OpenLiberty/space-sentry-challenge/instructions/SpaceShip Circuit Schematic.pdf

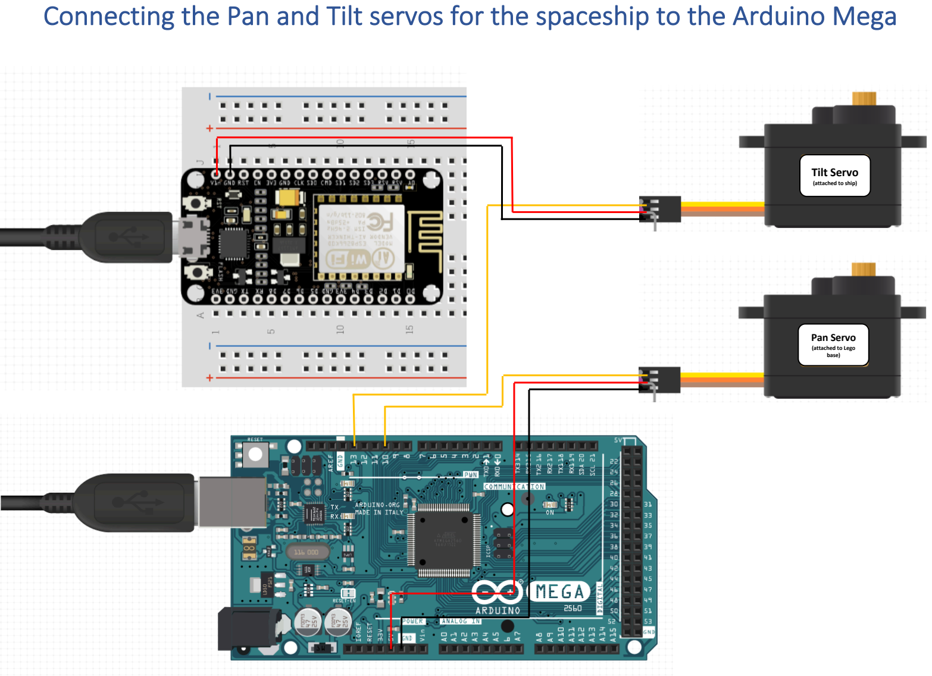
[picture p7: page 1]

Connecting the Pan and Tilt servos for the spaceship to the Arduino Mega

Tilt Servo

(attached to ship)

Pan Servo

(attached to Lego
base)

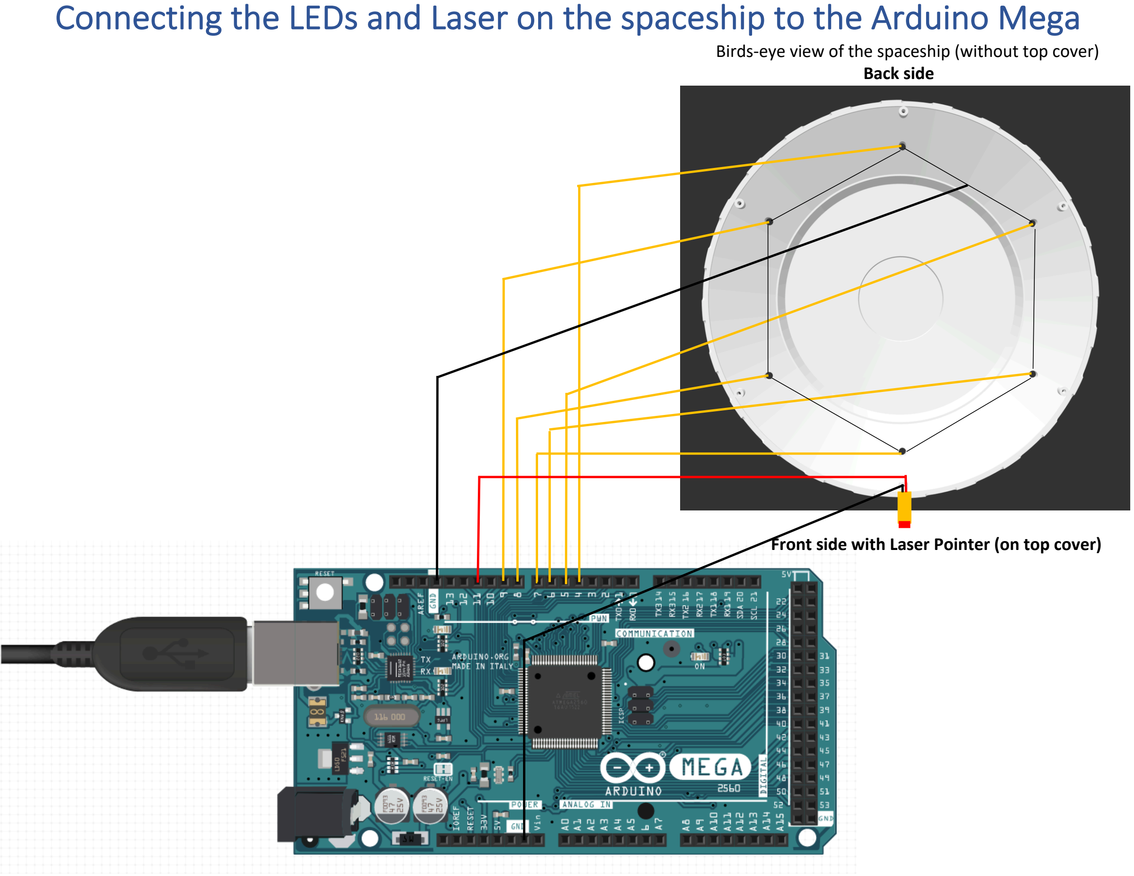
[picture p8: page 2]

Connecting the LEDs and Laser on the spaceship to the Arduino Mega Birds-eye view of the spaceship (without top cover)

Back side

Front side with Laser Pointer (on top cover)

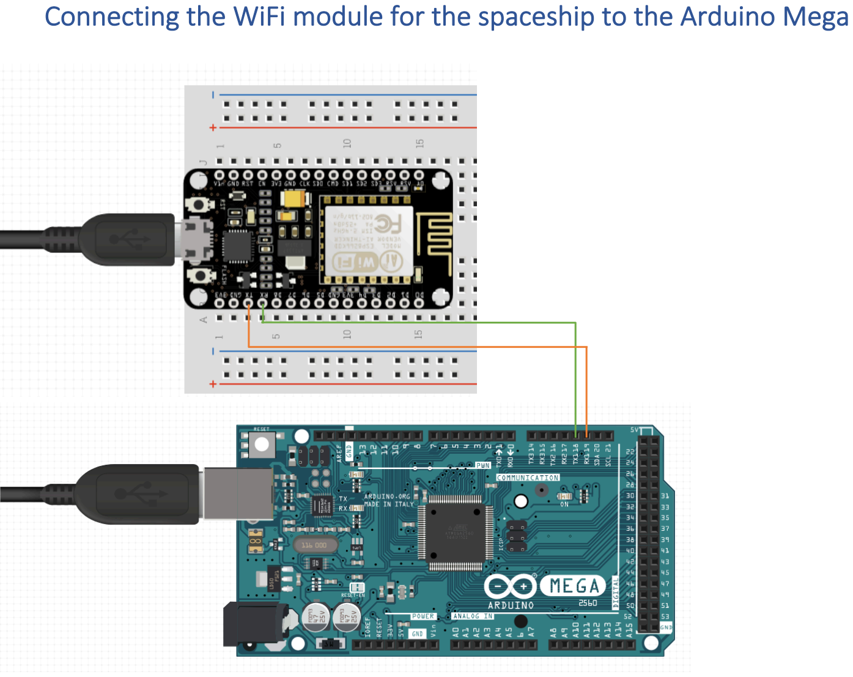
[picture p9: page 3]

Connecting the WiFi module for the spaceship to the Arduino Mega

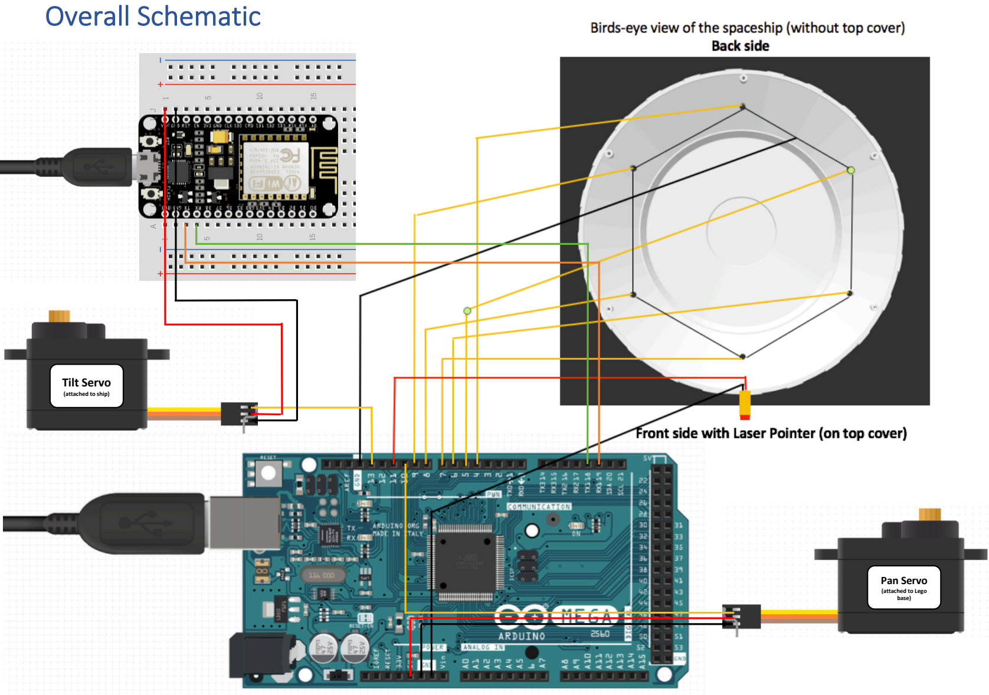
[picture p10: page 4]

Overall Schematic

Tilt Servo

(attached to ship)

Pan Servo

(attached to Lego
base)
