OpenLiberty/space-sentry-challenge/RaspberryPi/python/firstframe.bmp

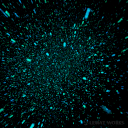
RaspberryPi/python/firstframe.bmp
