OpenLiberty/space-sentry-challenge/RaspberryPi/python/open.jpeg

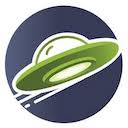
RaspberryPi/python/open.jpeg
