OpenLiberty/space-sentry-challenge/RaspberryPi/python/pulplecloud.gif

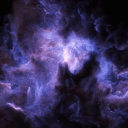
RaspberryPi/python/pulplecloud.gif
