OpenLiberty/space-sentry-challenge/RaspberryPi/python/shootingStar.gif

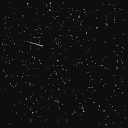
RaspberryPi/python/shootingStar.gif
