OpenLiberty/space-sentry-challenge/RaspberryPi/python/whitehole.gif

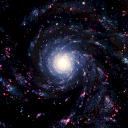
RaspberryPi/python/whitehole.gif
