OpenLiberty/space-sentry-challenge/hardware/parts-list.md

Required Tools
---
- Soldering Iron (Generic)
- Solder Wire (Lead Free)
- Wire Strippers (Capable of stripping 22-28 AWG wiring)
- Open Barrel Terminal Crimper (Capable of crimping 22-28 AWG wiring)
- Wire Cutters (Generic)
- Spools of 24AWG Flex Wire (multiple colours)
- Hook-up Wire 24AWG (multiple colours)
- Heat Shrink Tubing (multiple sizes)
- Desolder Pump
- Thin Tipped Tweezers (makes the soldering of the surface mount resistors much easier)
- Helping Hands (makes the soldering of wires much easier)
- Fine Conical Soldering Iron Tip (makes the soldering of small components easier)
- Multimeter (not necessary for the functionality of the build, however is very useful in the building and testing phases)

Required Components:
---
- The custom PCB Arduino shield documentation can be found in the [pcb-shield.md](pcb-shield.md) file, for steps on ordering the boards, refer to the [pcb-ordering.md](pcb-ordering.md) file.
- Arduino MEGA 2560
- USB-A Female Surface Mount Socket
- 5V 1A USB Port Power Supply
- USB-A Cable
- ESP8266 Wifi Module
- Female to Female Jumper Wire
- Break-away 0.1" Dual Row Male Header Pin Strip (at least 18 long)
- Break-away 0.1" Single Row Male Header Pin Strip (at least 10 long)
- Break-away 0.1" Single Row Dual Side Male Header Pin Strip (at least 4 long)
- 51 x Molex Part #39000046 (Mini-Fit Female Crimp Terminal 22-28 AWG)
- 51 x Molex Part #39000048 (Mini-Fit Male Crimp Terminal 22-28 AWG)
- 5 x Micro Servo
- 5 x 12mm Photoresistor
- 5 x 10kOhm 1206 SMD Resistors

Servo Connectors:
- 1 x Molex Part #39012160 (Intermediate connector for servo wires (M) 16 wire)
- 1 x Molex Part #39289168 (Board connector for servo wires (F) 16 wire)
- 5 x Molex Part #39014032 (Intermediate connector for servo wires (M) 3 wire)
- 5 x Molex Part #39014030 (Intermediate connector for servo wires (F) 3 wire)

Photoresistor Connectors:
- 1 x Molex Part #39012100 (Intermediate connector for the photo-resistors (M) 10 wire)
- 1 x Molex Part #39289108 (Board connector for the photo-resistors (F) 10 wire)
- 5 x Molex Part #39012020 (Intermediate connector for the photo-resistors (M) 2 wire)
- 5 x Molex Part #39012021 (Intermediate connector for the photo-resistors (F) 2 wire)

Suggested Retailors and Notes:
---
Note that the quantities listed for the components above are the _required minimum_. It is highly recommended to buy multiple extras as there will be parts that will get lost or broken.

Most of the components were purchased through the **[Digi-Key](https://www.digikey.ca/)** website. Copy the part number as listed above, and throw them in the product search window of the website.



An example using the part #39012160:



The common parts and tools can also be easily found in your local electronic hobby stores. Amazon is also a reliable and quick online retailor.
