OpenLiberty/space-sentry-challenge/instructions/assets/images/esp-connect.jpg

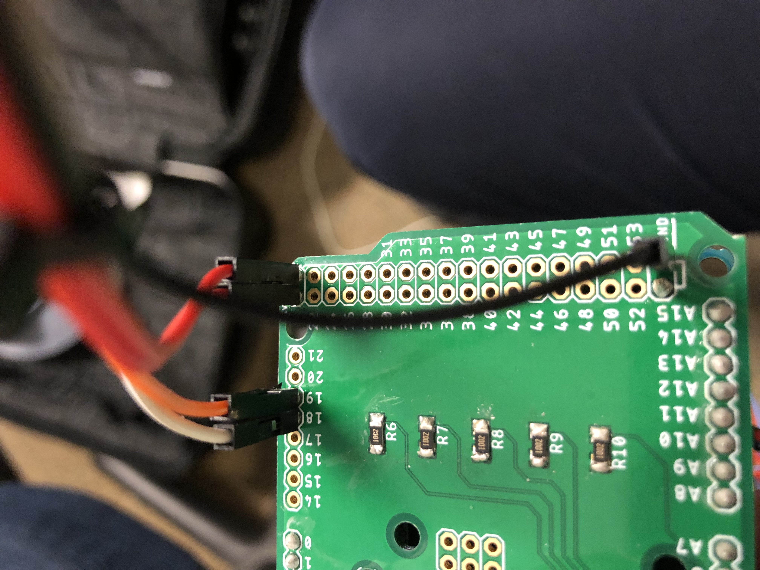
instructions/assets/images/esp-connect.jpg
