OpenLiberty/space-sentry-challenge/instructions/assets/images/IMG_1947.jpg

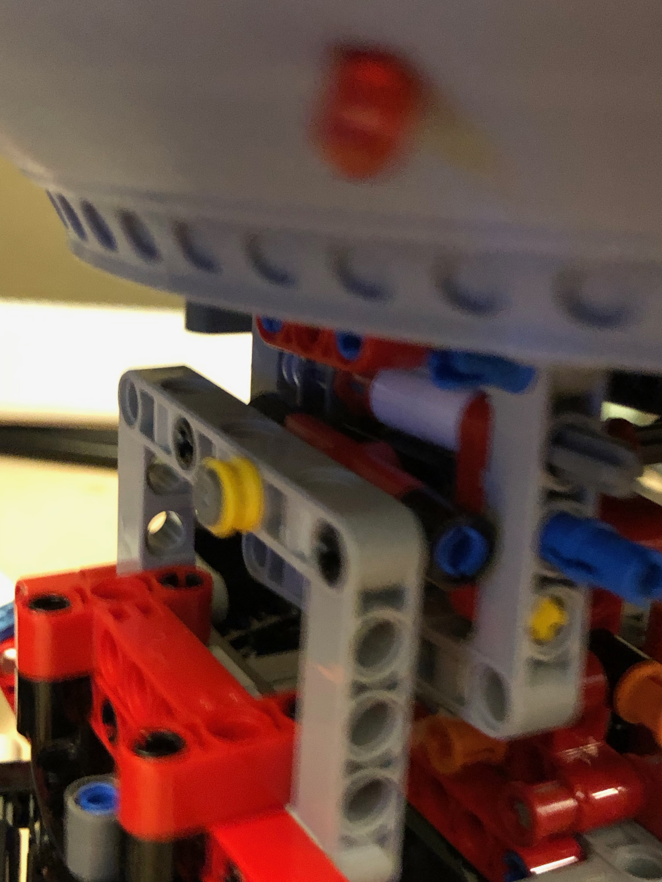
instructions/assets/images/IMG_1947.jpg
