OpenLiberty/space-sentry-challenge/instructions/assets/images/IMG_1948.jpg

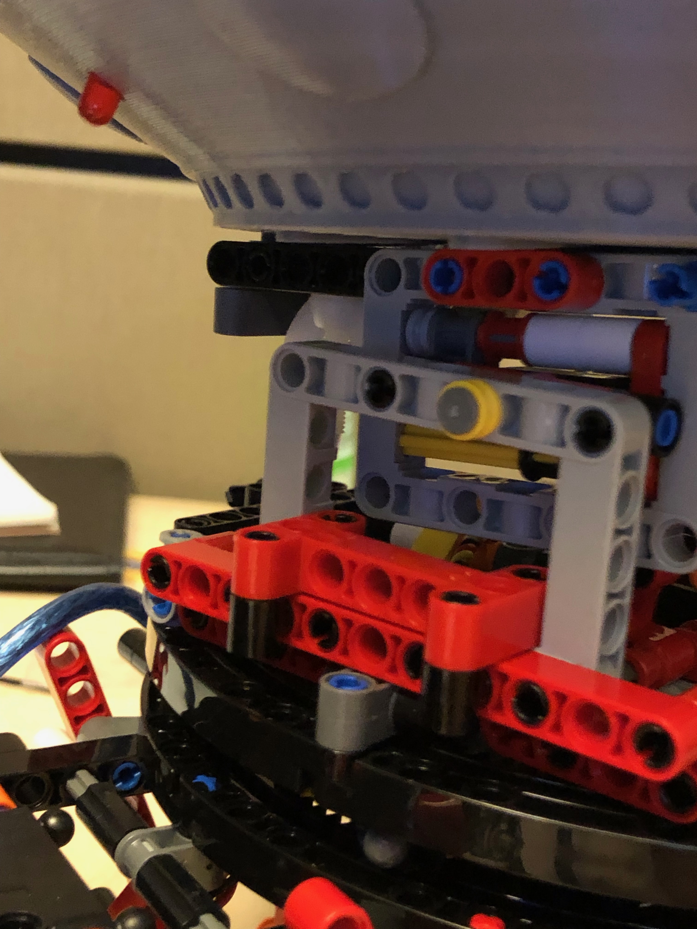
instructions/assets/images/IMG_1948.jpg
