OpenLiberty/space-sentry-challenge/instructions/assets/images/IMG_1951.jpg

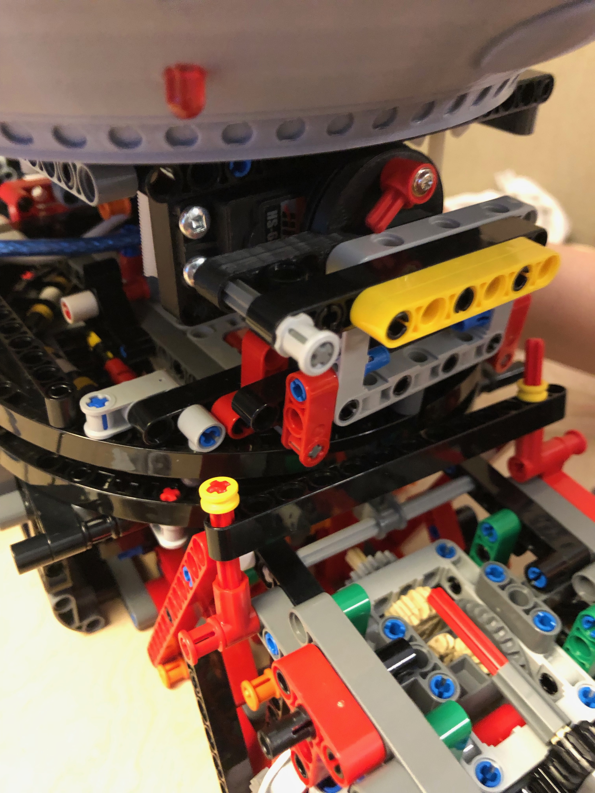
instructions/assets/images/IMG_1951.jpg
