OpenLiberty/space-sentry-challenge/instructions/assets/images/IMG_1952.jpg

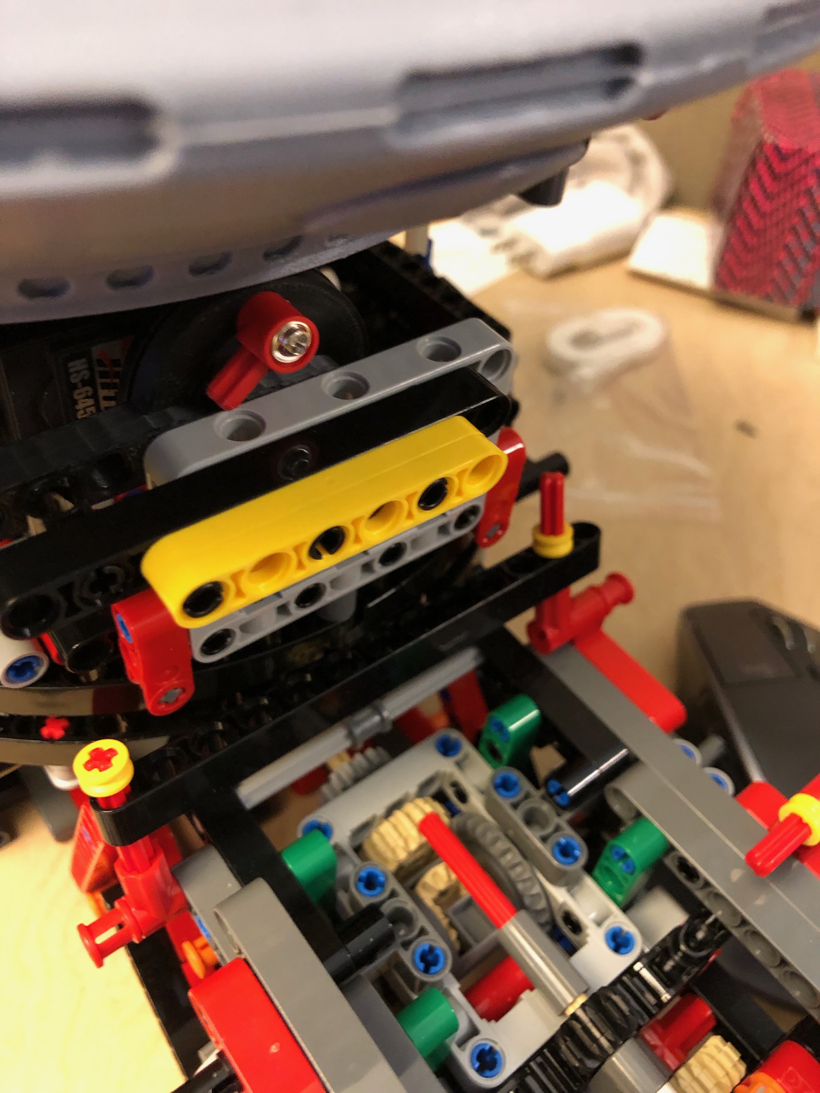
instructions/assets/images/IMG_1952.jpg
