OpenLiberty/space-sentry-challenge/instructions/assets/images/IMG_1953.jpg

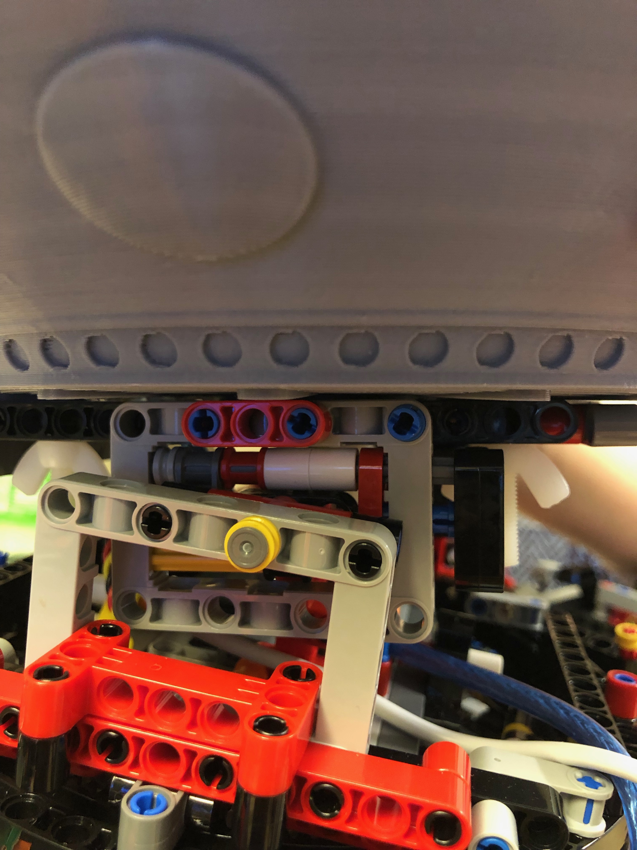
instructions/assets/images/IMG_1953.jpg
