OpenLiberty/space-sentry-challenge/instructions/assets/images/IMG_1954.jpg

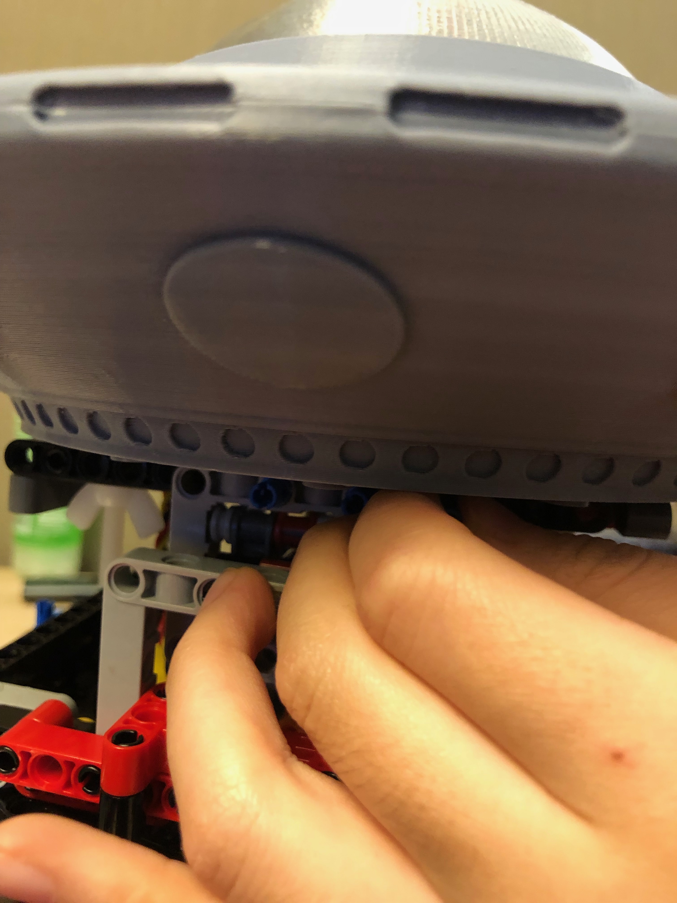
instructions/assets/images/IMG_1954.jpg
