OpenLiberty/space-sentry-challenge/instructions/assets/images/IMG_1957.jpg

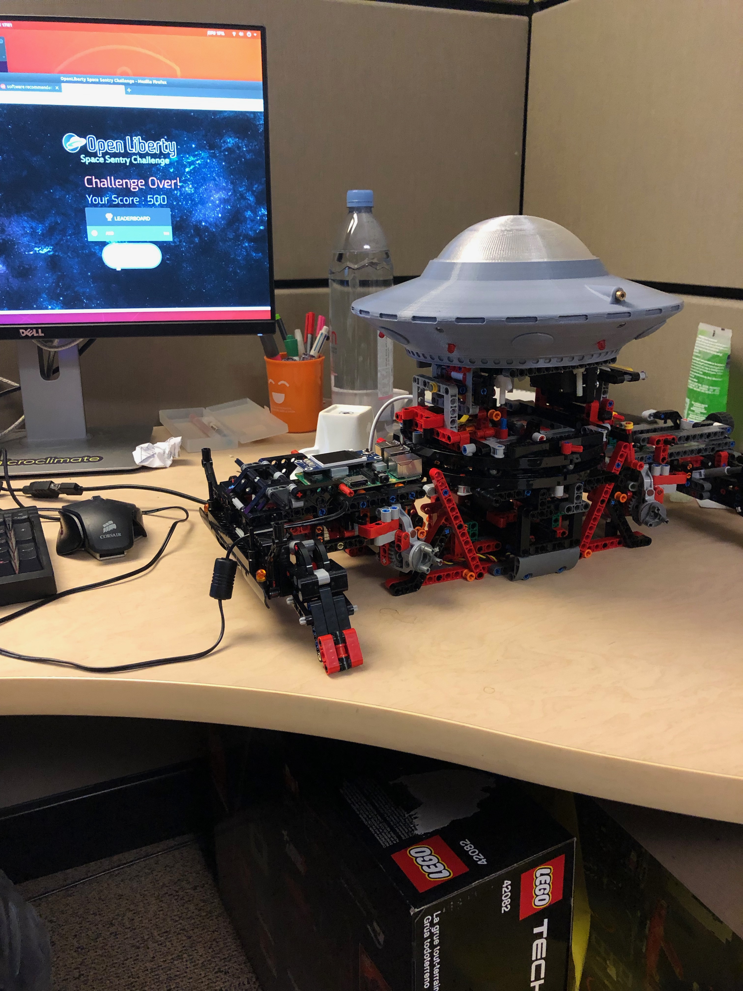
instructions/assets/images/IMG_1957.jpg
