OpenLiberty/space-sentry-challenge/instructions/assets/images/IMG_1965.jpg

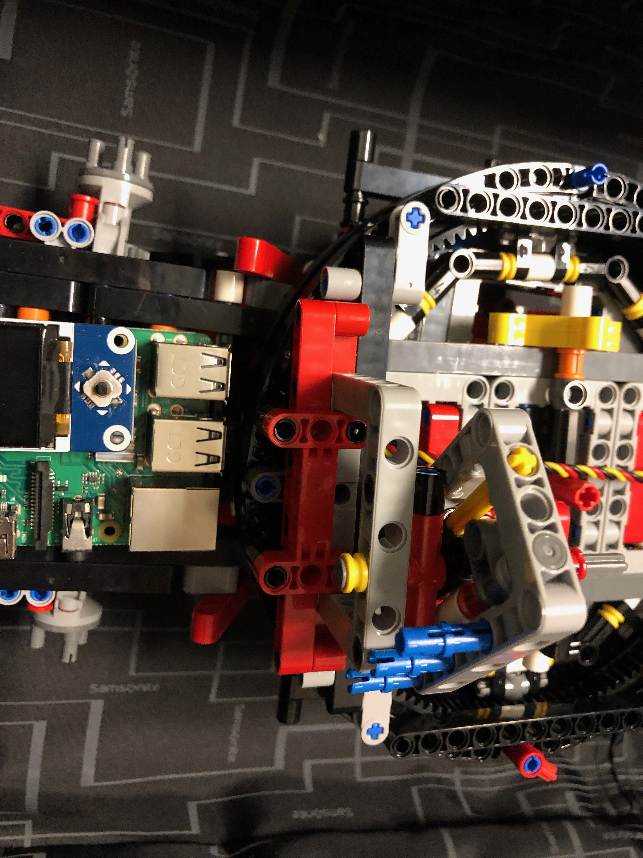
instructions/assets/images/IMG_1965.jpg
