OpenLiberty/space-sentry-challenge/instructions/assets/images/IMG_1966.jpg

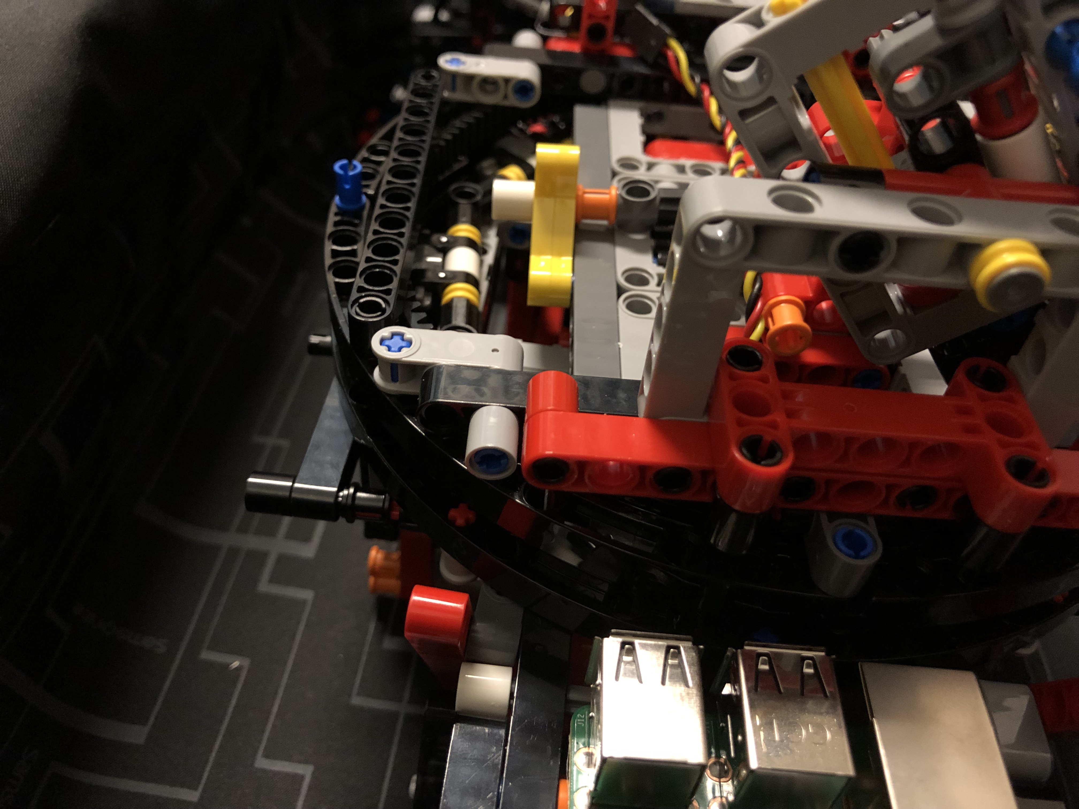
instructions/assets/images/IMG_1966.jpg
