OpenLiberty/space-sentry-challenge/instructions/assets/images/IMG_1967.jpg

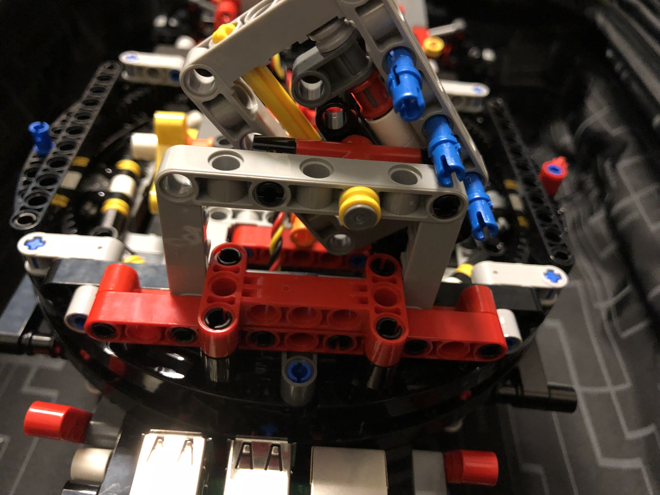
instructions/assets/images/IMG_1967.jpg
