OpenLiberty/space-sentry-challenge/instructions/assets/images/IMG_1968.jpg

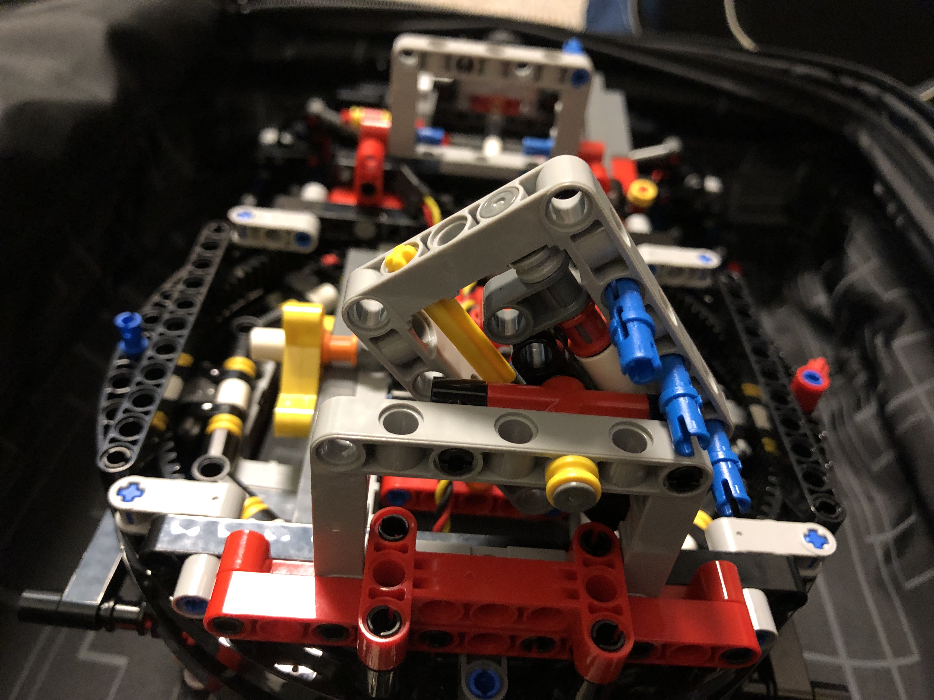
instructions/assets/images/IMG_1968.jpg
