OpenLiberty/space-sentry-challenge/instructions/assets/images/IMG_1969.jpg

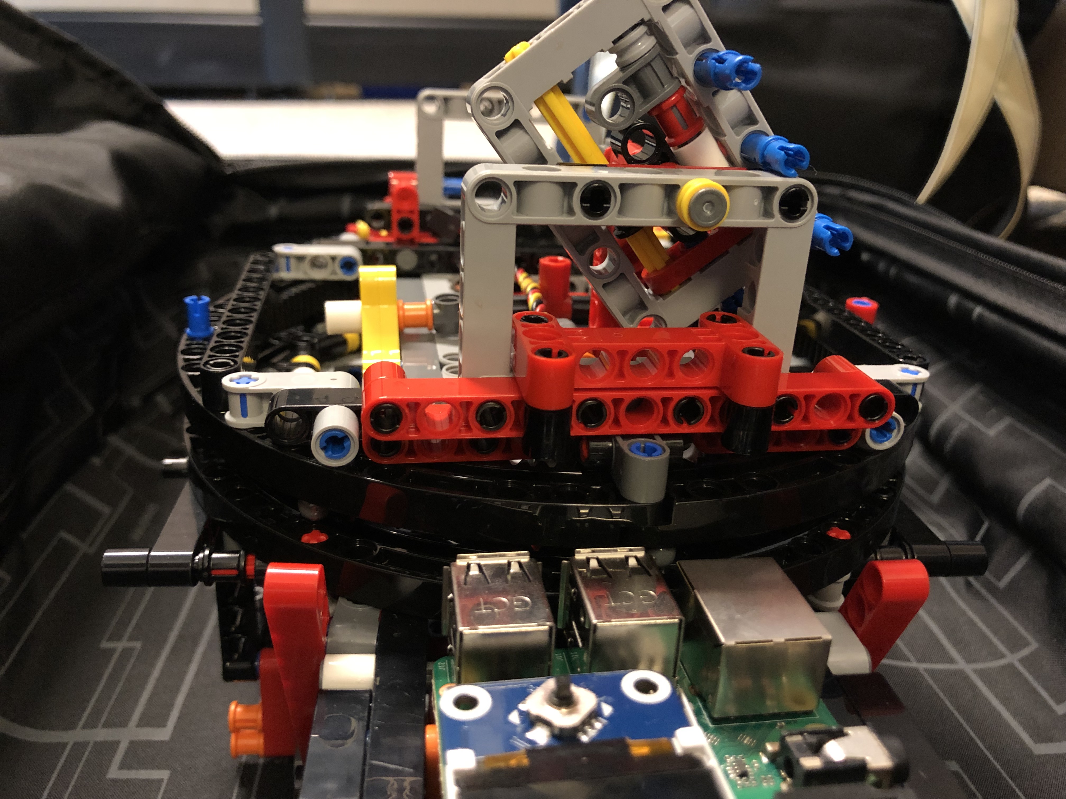
instructions/assets/images/IMG_1969.jpg
