OpenLiberty/space-sentry-challenge/instructions/assets/images/IMG_1970.jpg

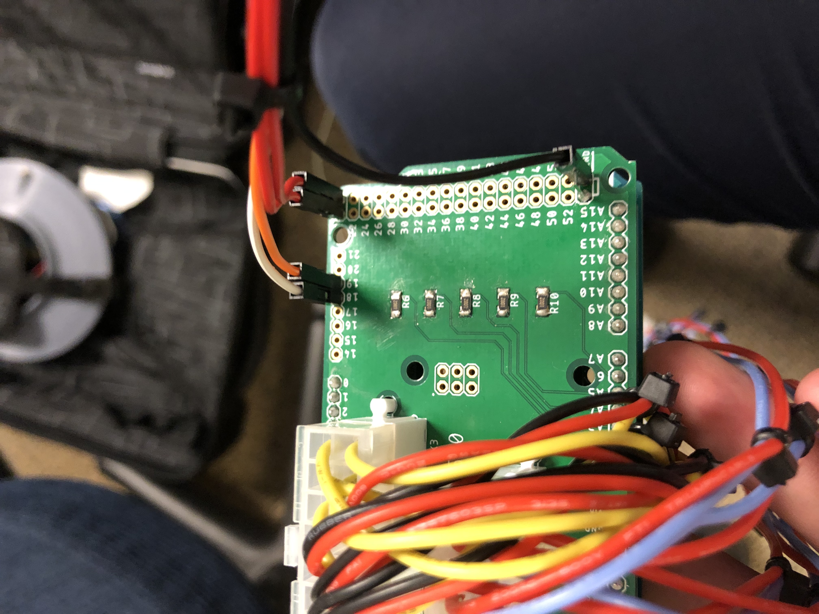
instructions/assets/images/IMG_1970.jpg
