OpenLiberty/space-sentry-challenge/instructions/assets/images/IMG_1972.jpg

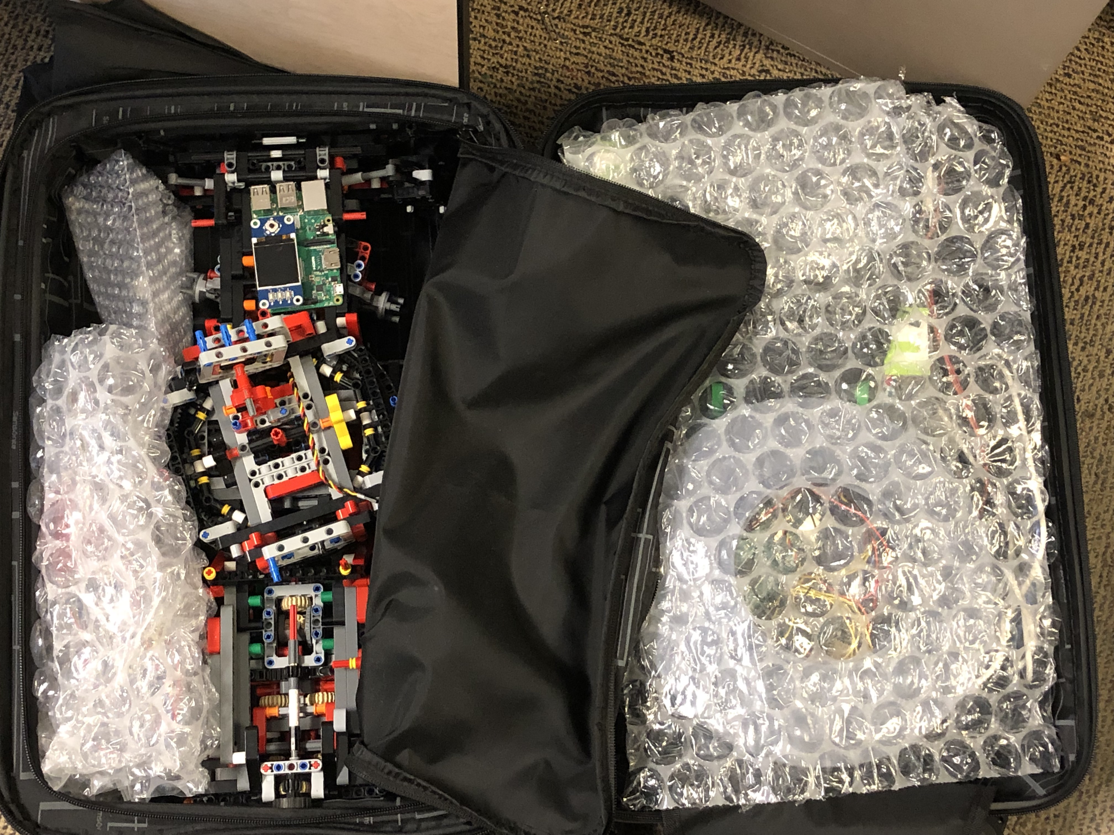
instructions/assets/images/IMG_1972.jpg
