OpenLiberty/space-sentry-challenge/instructions/assets/images/IMG_1973.jpg

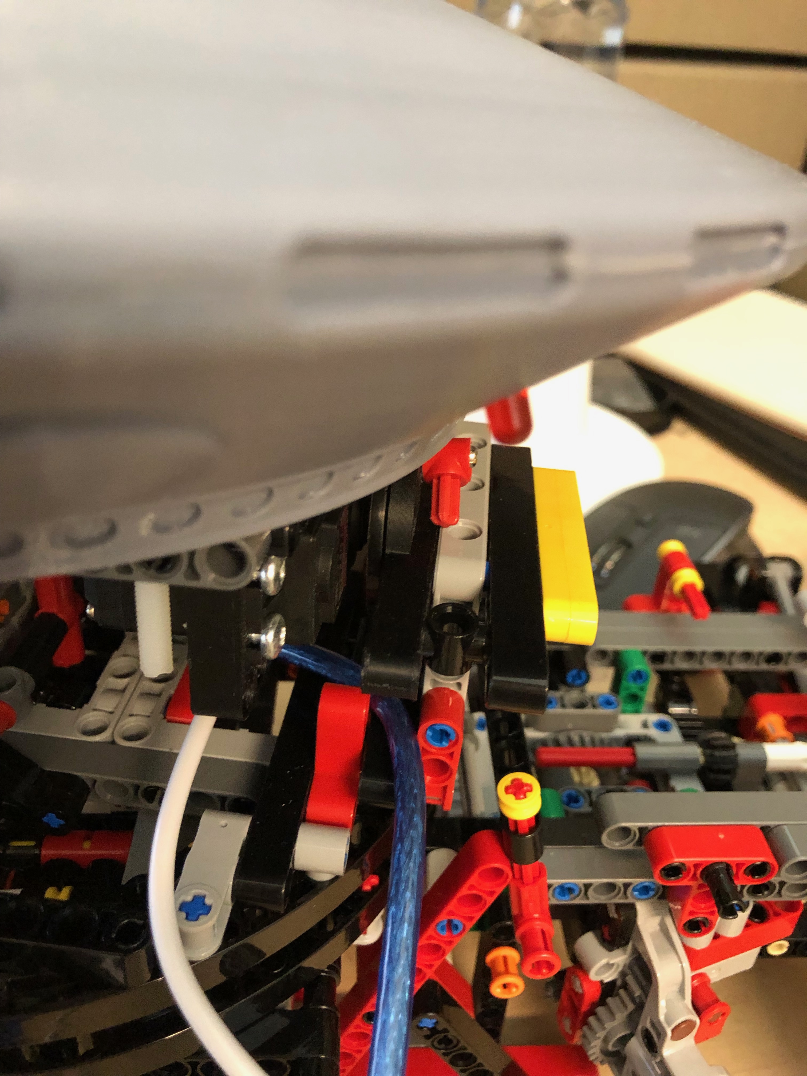
instructions/assets/images/IMG_1973.jpg
