OpenLiberty/space-sentry-challenge/instructions/assets/images/IMG_1974.jpg

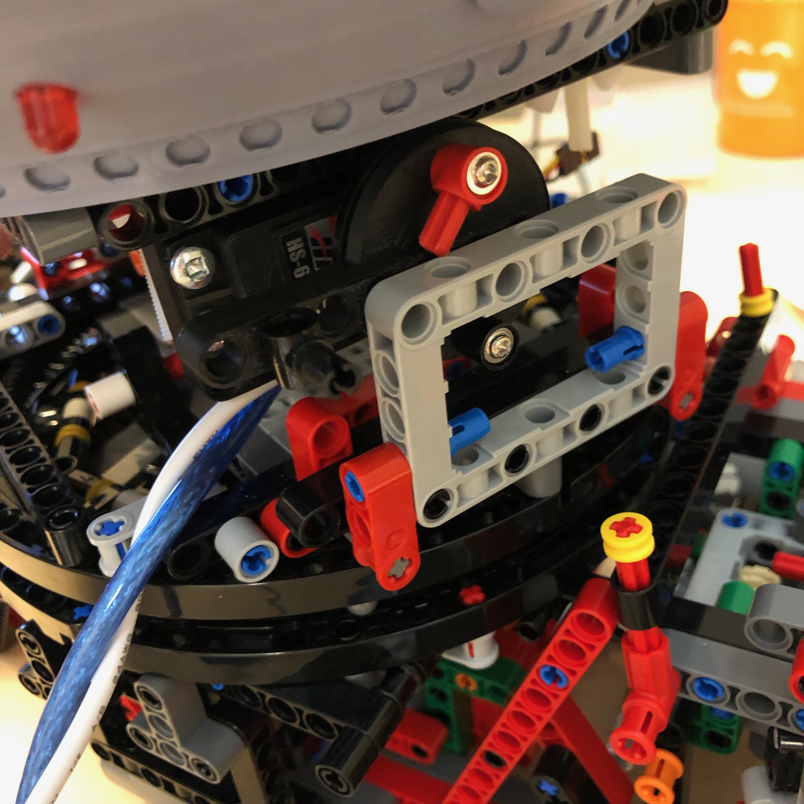
instructions/assets/images/IMG_1974.jpg
