OpenLiberty/space-sentry-challenge/instructions/assets/images/leftside-1.jpg

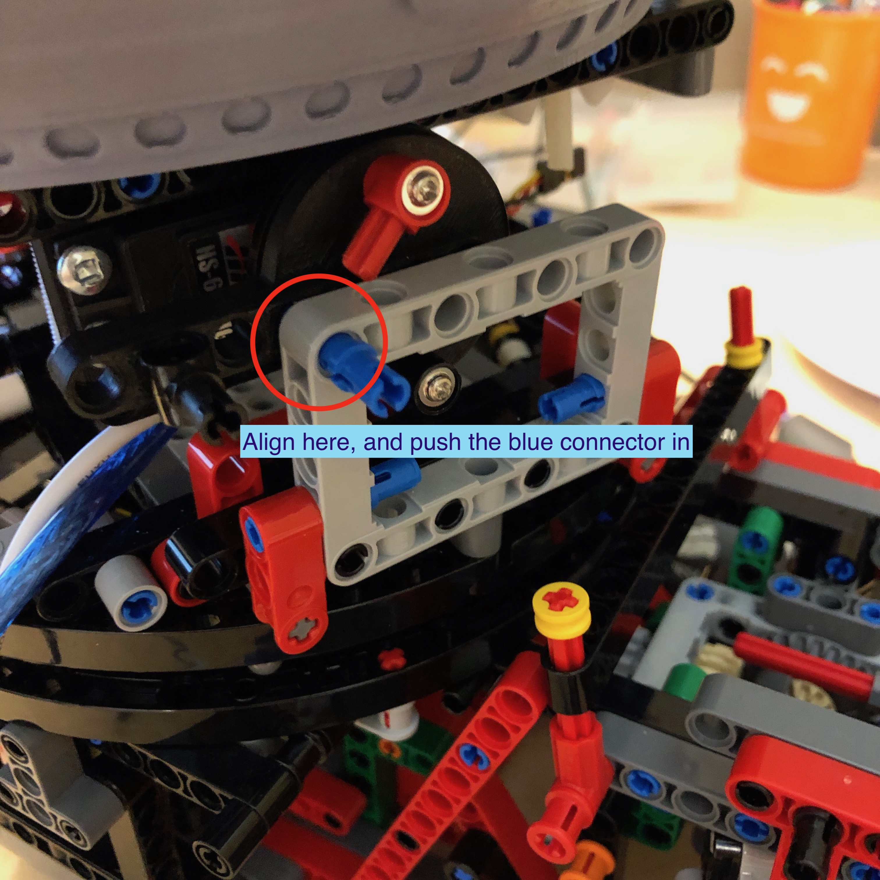
instructions/assets/images/leftside-1.jpg
