OpenLiberty/space-sentry-challenge/instructions/assets/images/leftside-2.jpg

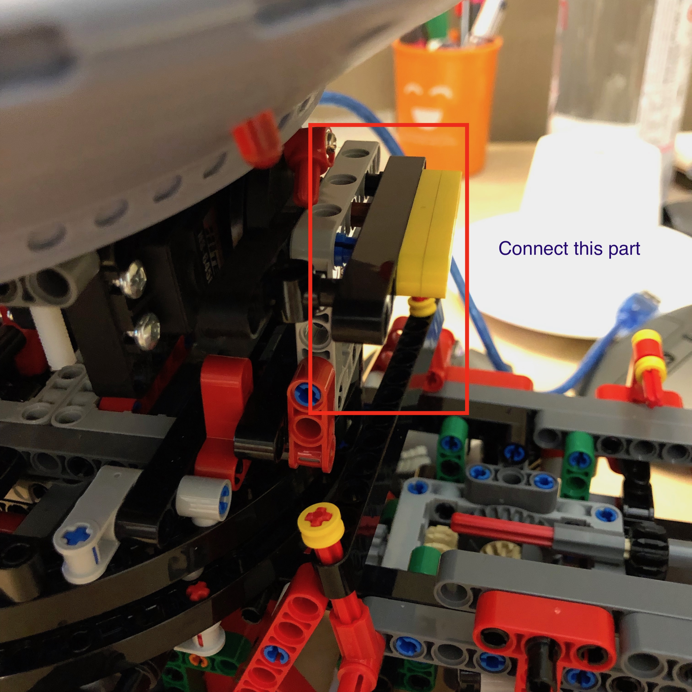
instructions/assets/images/leftside-2.jpg
