OpenLiberty/space-sentry-challenge/instructions/assets/images/leftside-3.jpg

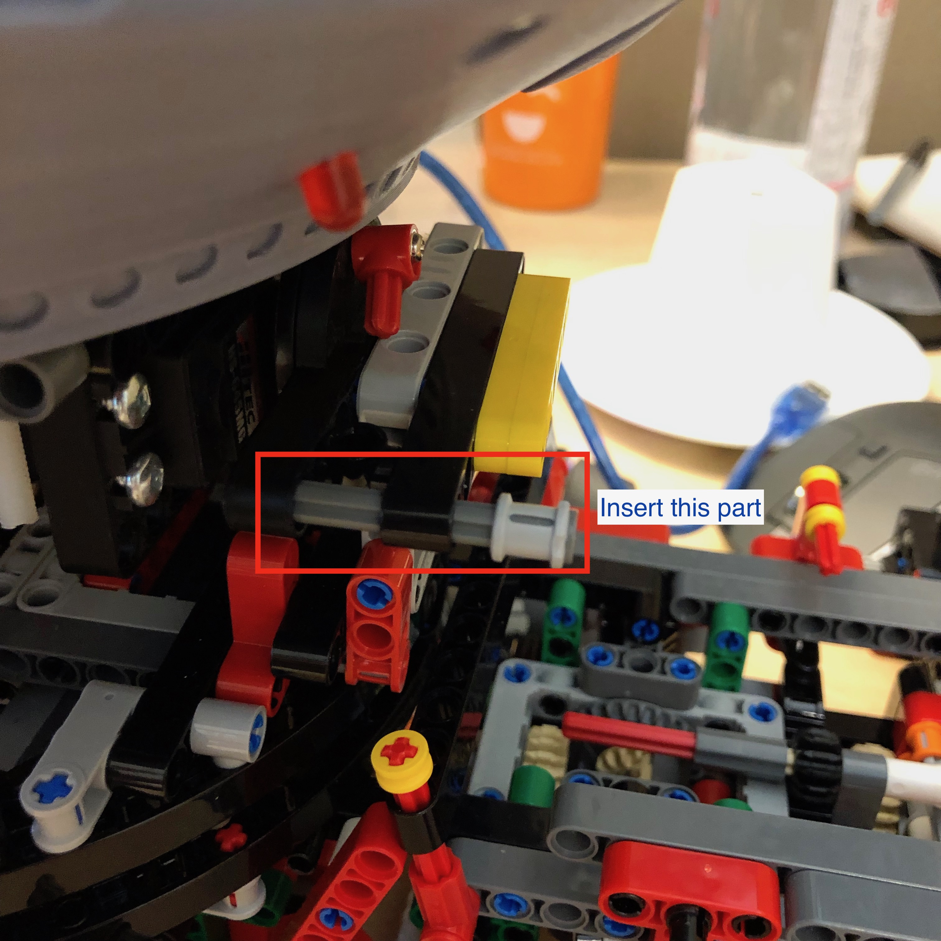
instructions/assets/images/leftside-3.jpg
