OpenLiberty/space-sentry-challenge/instructions/assets/images/mini-display.jpg

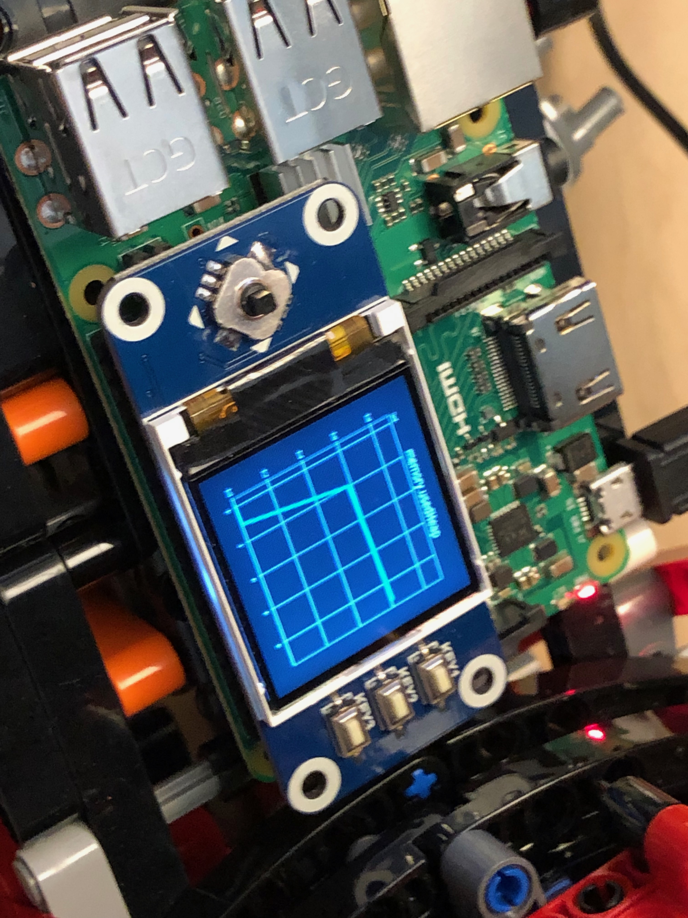
instructions/assets/images/mini-display.jpg
