OpenLiberty/space-sentry-challenge/instructions/assets/images/minipc-power.jpg

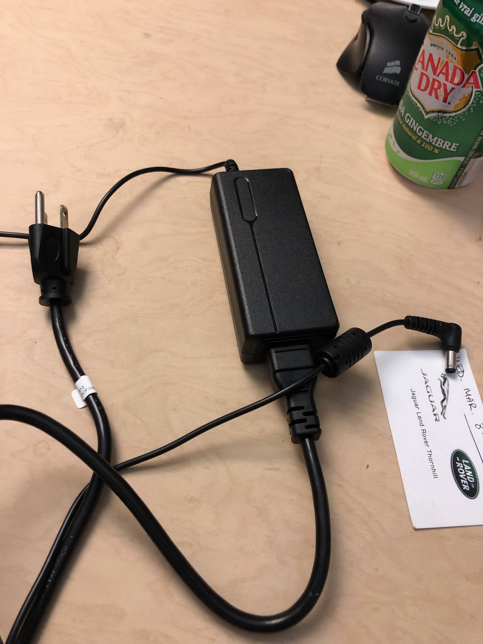
instructions/assets/images/minipc-power.jpg
