OpenLiberty/space-sentry-challenge/instructions/assets/images/minipc.jpg

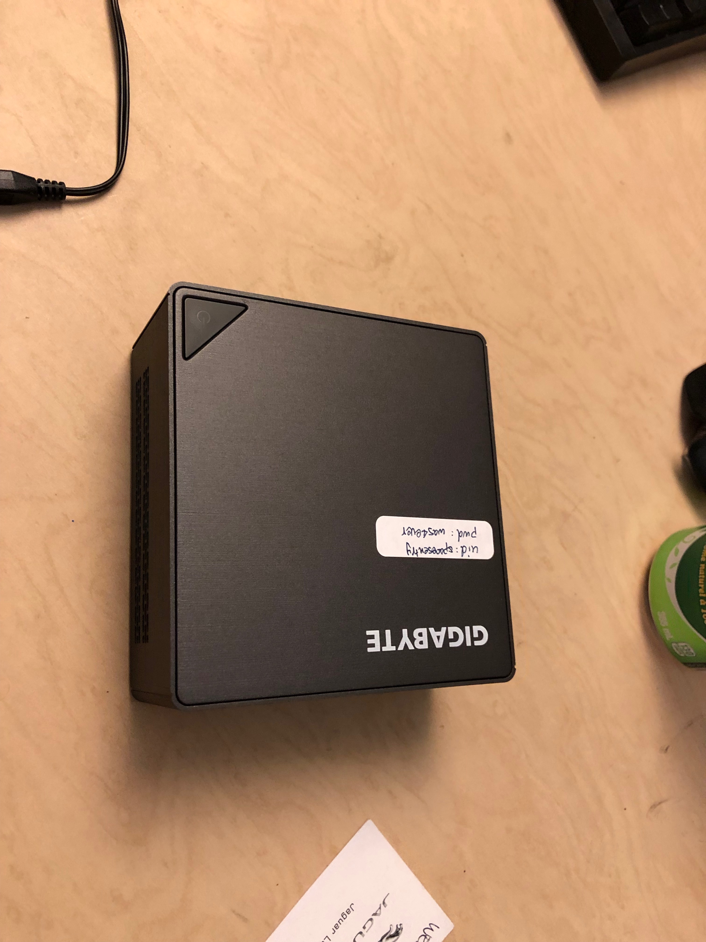
instructions/assets/images/minipc.jpg
