OpenLiberty/space-sentry-challenge/instructions/assets/images/rightside-1.jpg

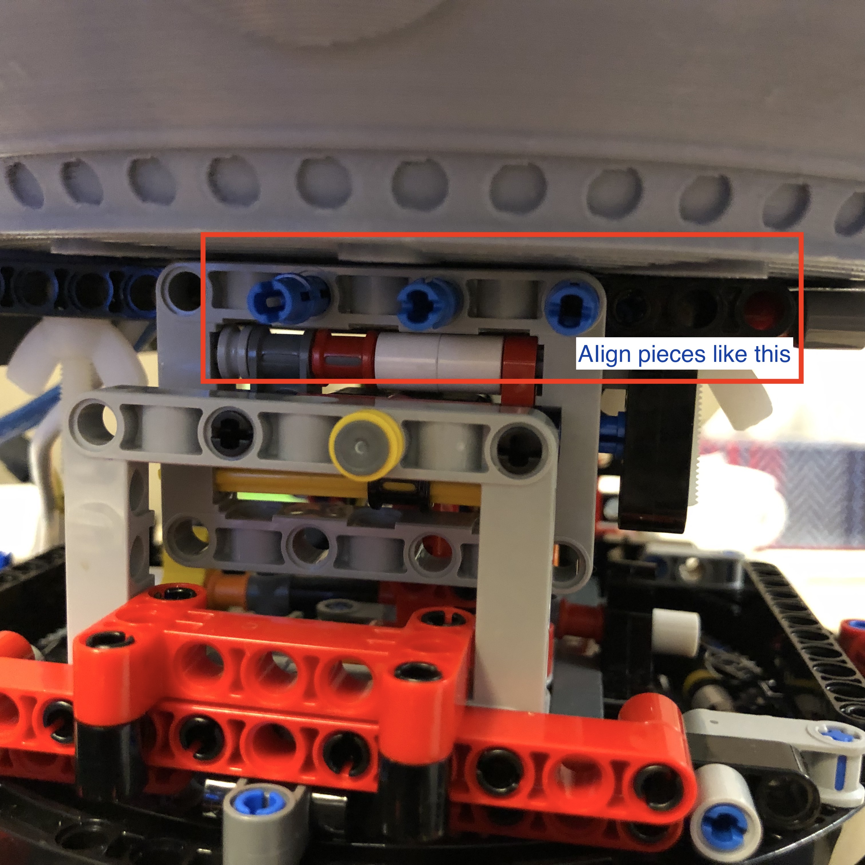
instructions/assets/images/rightside-1.jpg
