OpenLiberty/space-sentry-challenge/instructions/assets/images/rightside-2.jpg

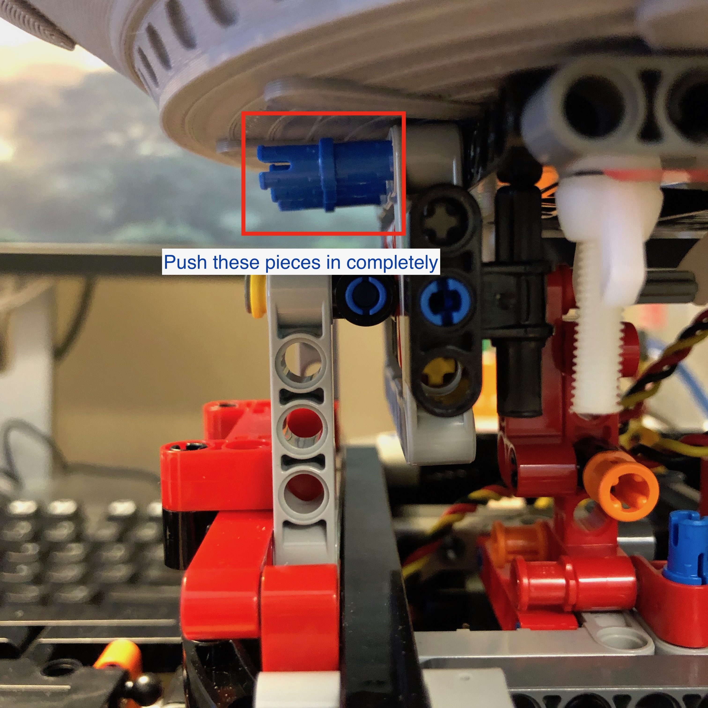
instructions/assets/images/rightside-2.jpg
