OpenLiberty/space-sentry-challenge/instructions/assets/images/rightside-3.jpg

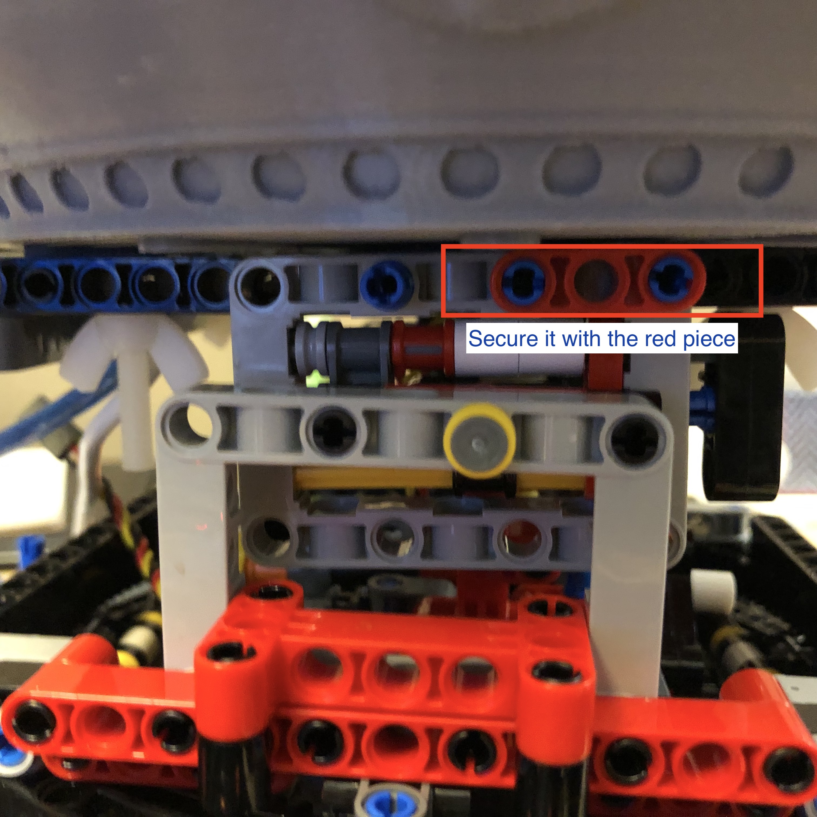
instructions/assets/images/rightside-3.jpg
