OpenLiberty/space-sentry-challenge/instructions/assets/images/servo-connect2.jpg

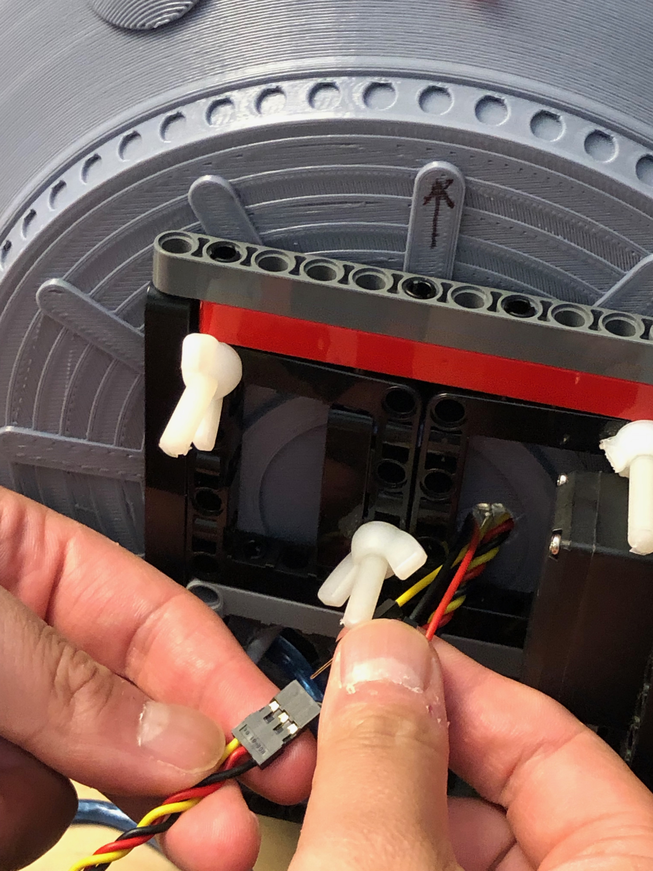
instructions/assets/images/servo-connect2.jpg
