OpenLiberty/space-sentry-challenge/instructions/assets/images/servo-connect.jpg

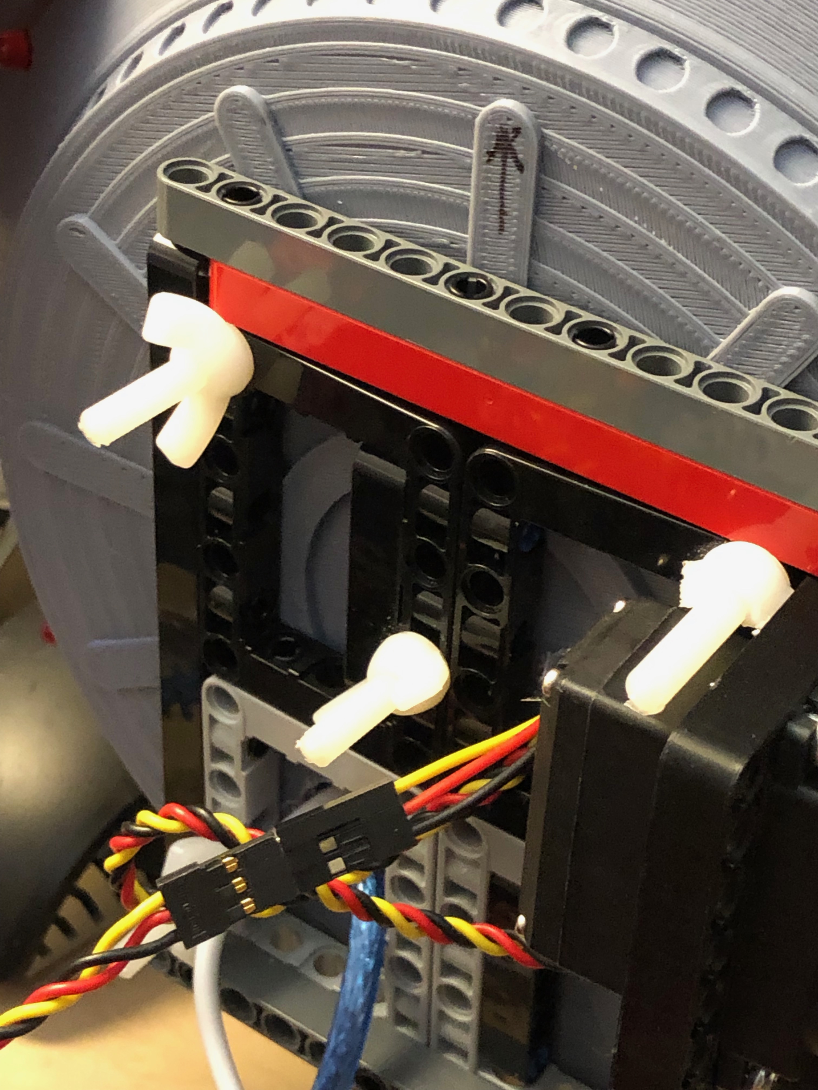
instructions/assets/images/servo-connect.jpg
