OpenLiberty/space-sentry-challenge/instructions/assets/images/targets-arduino.jpg

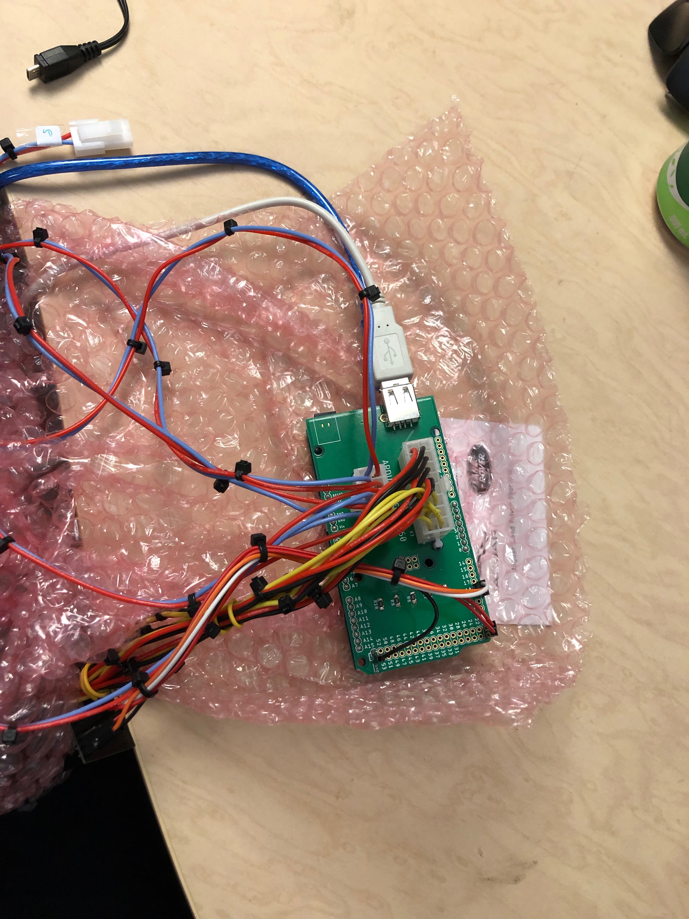
instructions/assets/images/targets-arduino.jpg
