OpenLiberty/space-sentry-challenge/instructions/assets/images/targets-connect.jpg

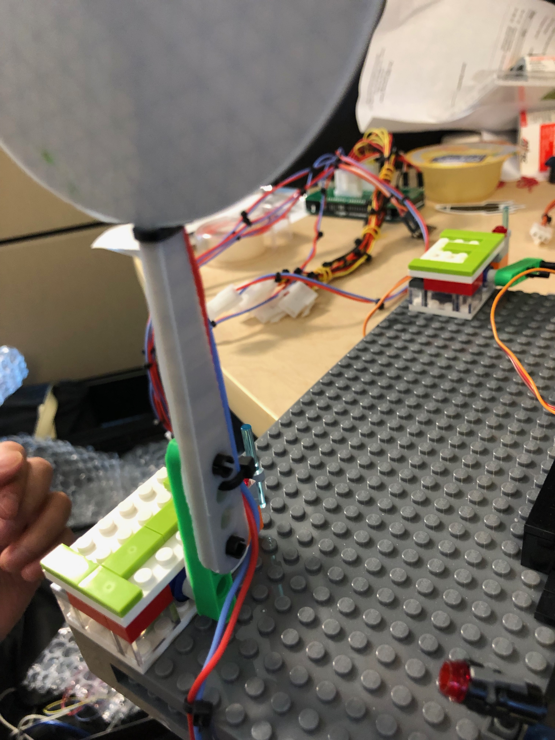
instructions/assets/images/targets-connect.jpg
