OpenLiberty/space-sentry-challenge/(threads)

Thread 2 (2019-05-30):

Usable browser back button that won't break the game

fwji, 2019-05-30:
Currently, hitting the back button in admin page or in the middle of the game session (as well as the leaderboard page) will not properly clean up all the resources. As a result, it will lead the whole web app to an unpredictable state.

Closed 2019-08-14.

Thread 7 (2019-05-30):

Adding a monitor to raspberry pi to display liberty logo and other animation

fwji, 2019-05-30:

BriannaLi, 2019-06-04:
Setting up git and python environment on Raspberry Pi. Installing image library. Doubt the ability of playing animation on 1.44 LCD

BriannaLi, 2019-06-04:
It is showing images. Adjusting open liberty logo for display.

BriannaLi, 2019-06-04:
Displaying Liberty logo

BriannaLi, 2019-06-04:
Trying to introduce tkinter for gif display.

BriannaLi, 2019-06-04:
May need low level code to display gif.

BriannaLi, 2019-06-05:
Able to change font of text

BriannaLi, 2019-06-05:
Adding sound

fwji, 2019-06-05:
<pre>
Container              Status
Admin                    Running
Game                     Running
Leaderboard         Running
nginx                     Running
mongo                  Running
</pre>

BriannaLi, 2019-06-06:
Added shooting effect. Adding blinking stars

BriannaLi, 2019-06-06:
Admin                    ●
Game                     ●
Leaderboard         ●
nginx                      ●
mongo                   ●

BriannaLi, 2019-06-07:
Got buttons work with GEIO library #20

fwji, 2019-06-10:
Sample JSON data to consume:

{"checks":[{"data":{"services":"available"},"name":"InventoryResource","state":"UP"},{"data":{"default server":"available"},"name":"SystemResource","state":"UP"}],"outcome":"UP"}

BriannaLi, 2019-06-13:
https://openliberty.io/guides/microprofile-health.html

BriannaLi, 2019-06-13:
Able to get and display json data from url(openliberty service)

BriannaLi, 2019-06-13:
Adding url not find exception

Closed 2019-06-18.

Thread 13 (2019-06-05):

Shopping List

fwji, 2019-06-05:
1. New router

MaiHameed, 2019-06-08:
*Arduino [Mega](https://store.arduino.cc/usa/mega-2560-r3)*

The Mega has 15 PWM ports, which eliminates the need of the intermediary PWM board that was used to power the servos. We can plug the motors straight into the Mega instead.

MaiHameed, 2019-06-12:
**Multimeter**

For obvious reasons :D

DannyS03, 2019-06-12:
Multi-meter

MaiHameed, 2019-06-13:
[USB-C Hub](https://www.amazon.ca/dodowin-Multiport-Ethernet-Thunderbolt-Compatible/dp/B07LBR5PBB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)

MaiHameed, 2019-07-15:
Intermediate connector for servo wires (M) 16 wire
1 x [39012160](https://www.digikey.ca/products/en?keywords=39012160)

Board connector for servo wires (F) 16 wire
1 x [39289168](https://www.digikey.ca/products/en?keywords=39289168)

Intermediate connector for servo wires (M) 3 wire
5 x [39014032](https://www.digikey.ca/products/en?keywords=39014032)

Intermediate connector for servo wires (F) 3 wire
5 x [39014030](https://www.digikey.ca/products/en?keywords=39014030)

Intermediate connector for the photo-resistors (M) 10 wire
1 x [39012100](https://www.digikey.ca/products/en/connectors-interconnects/rectangular-connectors-housings/319?k=39012100)

Board connector for the photo-resistors (F) 10 wire
1 x [39289108](https://www.digikey.ca/products/en?keywords=39289108)

Intermediate connector for the photo-resistors (M) 2 wire
5 x [39012020](https://www.digikey.ca/products/en?keywords=39012020)

Intermediate connector for the photo-resistors (F) 2 wire
5 x [39012021](https://www.digikey.ca/products/en?keywords=39012021)

Mini-Fit Female Crimp Terminal 22-28 AWG
51 x [39000046](https://www.digikey.ca/product-detail/en/molex/0039000046/WM2503TR-ND/1643436)

Mini-Fit Male Crimp Terminal 22-28 AWG
51 x [39000048](https://www.digikey.ca/product-detail/en/molex/0039000048/WM2502TR-ND/1643437)

6 multi-coloured spools of 22 AWG wire - SparkFun
1 x [PRT-11367](https://www.digikey.ca/product-detail/en/sparkfun-electronics/PRT-11367/1568-1357-ND/5956251)

Titan 11477 Ratcheting Wire Terminal Crimper
1 x [Titan 11477](https://www.amazon.ca/Titan-11477-Ratcheting-Terminal-Crimper/dp/B0069TRKJ0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)

Weller WLC100CUL 40-Watt Soldering Station
1 x [Weller WLC100CUL](https://www.amazon.ca/Weller-WLC100CUL-40-Watt-Soldering-Station/dp/B00PVV6T1C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)

Weller ST7 TIP, CONICAL, 1/32"
1 x [ST7 TIP](https://www.amazon.ca/Weller-ST7-Conical-Solder-Hobbyist/dp/B0002BSP4K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)

Soldering Wire 0.031" (0.79mm)
1 x [0.79mm](https://www.digikey.ca/product-detail/en/chip-quik-inc/RASWLF.031-1OZ/RASWLF.0311OZ-ND/9681997)

Soldering Wire 0.015" (0.38mm)
1 x [0.38mm](https://www.digikey.ca/product-detail/en/chip-quik-inc/RASWLF.015-2OZ/RASWLF.0152OZ-ND/9682012)

MaiHameed, 2019-07-18:
10k Ohm Resistors
5 x [0603 10k](https://www.digikey.ca/product-detail/en/stackpole-electronics-inc/RNCP0603FTD10K0/RNCP0603FTD10K0CT-ND/2240478)

MaiHameed, 2019-08-21:
Shopping list is outdated, some components I ordered ended up not being correct and I switched a few around. For an updated list, check out the [parts-list.md](hardware/parts-list.md) file.

Closed 2019-08-21.

Thread 15 (2019-06-05):

Redesign the Web Application

pgunapal, 2019-06-05:
The current web application is a simple web page, that uses HTML, CSS, JavaScript/jQuery. It would be better to use the latest frameworks that are available for web designing, such as Angular, NodeJS, React, and etc.

Thread 16 (2019-06-05):

Some sound track is not working during game session

fwji, 2019-06-05:

fwji, 2019-07-10:
Seems like newest browser will automatically block sound being played from untrusted sources. Still unclear why some sound can still be played. But this can be fixed by simply configuring the browser to allow audio playback in any circumstances

Closed 2019-07-10.

Thread 9 (2019-06-05):

Keystroke recognition with Arduino

mavelyc, 2019-06-05:
Look into and integrate keystroke/keyboard input to locally test Arduino code with the servo motor

Closed 2019-06-12.

Thread 20 (2019-06-07):

Get buttons to work with monitor

BriannaLi, 2019-06-07:
Based on schematics, each buttons was assigned to a GEIO pin. Gonna bring in gpiozero library in to add button control.

http://www.waveshare.net/w/upload/6/6f/1.44inch-LCD-HAT-Schematic.pdf
http://www.waveshare.net/w/upload/9/9d/1.44inch_LCD_HAT_User_Manual_CN.pdf
https://gpiozero.readthedocs.io/en/stable/

Closed 2019-06-07.

Thread 22 (2019-06-07):

PCB board design and printing work

fwji, 2019-06-07:

MaiHameed, 2019-06-24:
Rough Schematic for the target system to Arduino is completed and attached
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

MaiHameed, 2019-07-18:
**Schematic and PCB Design v1**
---
Shown below is the board schematic and PCB design which shows the connections between the PCB itself and the 3 necessary headers: the 16 pin to servo, 10 pin to the photoresistors, and the USB-A female socket as the power supply.

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

MaiHameed, 2019-07-19:
Updated the PCB layout & sent out PCB for production, estimated arrival is next Friday latest. Also shown are the PCB renders.

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

MaiHameed, 2019-07-24:
PCBs have arrived!
---
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

MaiHameed, 2019-07-25:
An error was found in the circuitry layout, specifically the layout of the photo-resistors. Shown in the image below, the bottom figure was used in the print, however it was supposed to be the top. The PCB schematic and board was fixed as attached, and sent to print.
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

fwji, 2019-07-25:
That's partially my mistake for giving the wrong schematics.

MaiHameed, 2019-07-30:
New Breadboard Circuit
---
Shown is the schematic for the new breadboard circuit after removing the multiplexer and PWM driver. It simplifies the circuitry and removed unnecessary components. The pinouts are connected to the right Analog and Digital ports that the code is based on. This was a proof of concept that a code change and rewiring worked. All that's necessary is to implement the new board to replace the breadboard.

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

Closed 2019-08-14.

Thread 25 (2019-06-12):

Combining local servo motor implementation and keystroke recognition

DannyS03, 2019-06-12:
- Using Arduino Uno
- SG90 Servo Motors
- Starting with "WASD" keys
- Goal is to eventually develop towards websockets

Closed 2019-06-12.

Thread 26 (2019-06-12):

Considering different implementation for spaceship circuit

DannyS03, 2019-06-12:
Designing and/or using a different board layout that utilizes other electronic components to enhance servo control.

Examples of electronic components
- 555 Timer
- BC547 Transistor
- Diode(s)

Example Schematic
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

** *Not a necessity, but something that can be considered.* **

DannyS03, 2019-07-09:
- Leaving it for now due to time

Closed 2019-07-09.

Thread 27 (2019-06-13):

Syncronization of DualShock controller and local implementation

DannyS03, 2019-06-13:
- Servo control with PS4 Controller
- Arduino UNO
- SG90 Servo Motors

DannyS03, 2019-06-17:
- Able to use ps4 controller buttons to process user input requests
- Almost have the ps4 controlling servo motor

DannyS03, 2019-06-18:
- Looks to be smoother then keyboard and track pad

Closed 2019-06-19.

Thread 31 (2019-06-18):

Wirelessly controlling servo motor with game controller

DannyS03, 2019-06-18:
- using dualshock ps4 controller
- SG90 servo motor
- Arduino UNO

DannyS03, 2019-08-07:
- Quite tedious with current implementation
- Might come back to it

Closed 2019-08-07.

Thread 34 (2019-06-19):

Controlling multiple servo motors with controller

DannyS03, 2019-06-19:
- PS4 Controller
- SG90 servo motors
- Arduino UNO

- Also utilizing the analog controls on the ps4 controller in a way a user is used to playing similar games

Closed 2019-06-21.

Thread 38 (2019-06-21):

Switch between plots

BriannaLi, 2019-06-21:
Without interrupting getting data from url. May need sub-process

BriannaLi, 2019-06-25:
Works, can't open both guide together, need long press

BriannaLi, 2019-06-26:
can open both, but health is blank

Closed 2019-06-27.

Thread 40 (2019-06-24):

Sending requests via wifi module

DannyS03, 2019-06-24:
- ESP8266 version 1 WIFI module
- Arduino UNO
- AirPort Express Router

DannyS03, 2019-07-09:
- Previous issues with flashing Wi-Fi module seem to be from local environment
- Able to flash module now with desired firmware, although occasional issue of
` Timed out waiting for packet header` still occurs
- Testing to send & receive requests

Closed 2019-07-09.

Thread 46 (2019-06-27):

Create Liberty docker image for Raspberry Pi

BriannaLi, 2019-06-27:
https://github.com/OpenLiberty/ci.docker/blob/master/official/latest/kernel/java8/openj9/Dockerfile

BriannaLi, 2019-06-27:
https://wiki.onap.org/display/DW/Migrating+Dockerfiles+from+Debian+apt+to+Alpine+apk

BriannaLi, 2019-06-27:
https://github.com/OpenLiberty/ci.docker/blob/19c93b7ddbc4583222f37ac542a92a76166b7166/official/latest/webProfile8/java8/ibmsfj/Dockerfile

BriannaLi, 2019-06-28:
Dockerfile stucks at Step 10/16 : RUN /opt/ol/wlp/bin/server create     && rm -rf $WLP_OUTPUT_DIR/.classCache /output/workarea
 ---> Running in e03628b1e16e when Configuring Open Liberty

Closed 2019-07-03.

Thread 58 (2019-07-09):

Implementing wifi module with servo motor circuit

DannyS03, 2019-07-09:
- Arduino UNO
- SG90 Servo Motors to start
- esp8266 version 1 Wi-Fi module
- AirPort Express Router

DannyS03, 2019-07-09:
- [ ] Module to be able to receive requests
- [ ] Updating current Arduino code for integration

Closed 2019-08-07.

Thread 66 (2019-08-07):

Remove jittering from servo motors

DannyS03, 2019-08-07:

DannyS03, 2019-08-07:
- changed to Arduino Mega which eliminates common interrupt issues

Closed 2019-08-07.

Thread 71 (2019-08-20):

Oracle Code One check list

fwji, 2019-08-20:
- [ ] 1. New web app thoroughly tested and bug free
- [ ] 2. Spaceship random disconnect issue fix
- [ ] 3. All documents properly uploaded especially on the lego assembly and docker setup guides
- [ ] 4. Spaceship control improvements (Alasdair's suggestion)
- [ ] 5. New Router

Thread 72 (2019-08-21):

Shopping list for a rebuild of Space Sentry V2

MaiHameed, 2019-08-21:
Servo Connectors
---
- [x] Intermediate connector for servo wires (M) 16 wire
3 x [39012160](https://www.digikey.ca/products/en?keywords=39012160)

- [x] Board connector for servo wires (F) 16 wire
3 x [39289168](https://www.digikey.ca/products/en?keywords=39289168)

- [x] Intermediate connector for servo wires (M) 3 wire
8 x [39014032](https://www.digikey.ca/products/en?keywords=39014032)

- [x] Intermediate connector for servo wires (F) 3 wire
8 x [39014030](https://www.digikey.ca/products/en?keywords=39014030)

Resistors
---
- [x] 10k Ohm Resistors
15 x [1206 10k](https://www.digikey.ca/product-detail/en/bourns-inc/CRT1206-BY-1002ELF/CRT1206-BY-1002ELFCT-ND/1775051)

Photoresistor Connectors
---
- [x] Intermediate connector for the photo-resistors (M) 10 wire
3 x [39012100](https://www.digikey.ca/products/en/connectors-interconnects/rectangular-connectors-housings/319?k=39012100)

- [x] Board connector for the photo-resistors (F) 10 wire
3 x [39289108](https://www.digikey.ca/products/en?keywords=39289108)

- [x] Intermediate connector for the photo-resistors (M) 2 wire
8 x [39012020](https://www.digikey.ca/products/en?keywords=39012020)

- [x] Intermediate connector for the photo-resistors (F) 2 wire
8 x [39012021](https://www.digikey.ca/products/en?keywords=39012021)

External Power
---
- [x] USB-A socket
3 x [USB-A Female](https://www.sparkfun.com/products/9011)

Crimp Terminals
---
- [x] Mini-Fit Female Crimp Terminal 22-28 AWG
40 x [39000046](https://www.digikey.ca/product-detail/en/molex/0039000046/WM2503TR-ND/1643436)

- [x] Mini-Fit Male Crimp Terminal 22-28 AWG
40 x [39000048](https://www.digikey.ca/product-detail/en/molex/0039000048/WM2502TR-ND/1643437)

Wires
---
- [x] 24 AWG Flex Hookup Wire, multiple colours, they're 100ft each:
    - [x] 1 x [Black](https://www.digikey.ca/product-detail/en/daburn-electronics/2615-24-BK-100/2615-24-BK-100-ND/5246673)
    - [x] 1 x [Red](https://www.digikey.ca/product-detail/en/daburn-electronics/2615-24-RD-100/2615-24-RD-100-ND/5246676)
    - [x] 1 x [White](https://www.digikey.ca/product-detail/en/daburn-electronics/2615-24-WH-100/2615-24-WH-100-ND/5246679)

Creatron:
---
- [x] Heat Shrink Tubing
- [x] Zipties
- [x] Wire Strippers 22-28 AWG
1 x [Wire Strippers](https://www.creatroninc.com/product/30awg-professional-wire-stripper/?search_query=wire+strippers&results=1)

- [x] 12mm Photoresistor
8 x [Photoresistor](https://www.creatroninc.com/product/12mm-light-dependent-resistor-photo-resistor/)

- [x] Micro servos
8 x [Micro servos](https://www.creatroninc.com/product/full-rotation-micro-servo-motor-15kgcm/?search_query=micro+servo&results=9)

MaiHameed, 2019-09-23:
Completed build

Closed 2019-09-23.

Thread 90 (2020-02-04):

Improvements needed for Build 2.0

pgunapal, 2020-02-04:
- Detailed instructions of software set up
- Router needs to be closer to everything
- Label better stickers on targets connector
- Make sure the color matching of the servo connectors on the spaceship are stated
- Add audio capability in the instructions and put the workaround in the instructions
- Add to test the devices from the Settings page in the docs
- Add the USB cable to charge PS4 in the luggage and tell them to charge the controller
- Add link to GitHub link to Web Page

MaiHameed, 2020-02-27:
# New Build Ideation

To fix the following pressing issues:
* Spaceship is hard to control
* Target motors keep dying

## Target Base
* Update the target board to be 3D printed instead of made of Lego, as Lego is easy to break apart.
* Each target motor will be placed in 3D printed pockets on the board, with velcro squares to keep them in place and be easily interchangeable with replacements. If not velcro, they can be bracket mounted on the board like so:
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
* The targets themselves can be shorter, and the diameter of the target also smaller to reduce strain on the motor targets.
* The wires that the servos would connect to can be permanently stuck onto the target board closer to the servo mounts/pockets, and so it's obvious which plug the servos need to connect to, see image below:
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

* The LDR and motor wires can be either on top of the board, visible, or run underneath to be cleaner, and there can be cutouts near each pocket for the wires to run through, no need to label motors and LDRs in this case:
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

## Target Arduino
* Currently the WiFi module is hanging off the PCB, connected only via male-male pins. Adding slots to the PCB to solder the module on would make it more robust.

## Spaceship Control
* Currently there is a web socket used to act as a middle man between the user input and the motor reading. Removing the middle man and just supplying the user input signal straight to the spaceship Arduino would completely mitigate all communication issues. To keep the wireless feature, we can add bluetooth capabilities to the spaceship Arduino.

MaiHameed, 2020-03-05:
Required Components for Target Base Build
---
- 1x 100' 10 wire ribbon cable, 26AWG [DigiKey](https://www.digikey.ca/product-detail/en/3m/3811-10-100/3M157850-100-ND/1107527)
- Heat Shrink Tubing (multiple sizes) Creatron
- 1x Arduino MEGA 2560 Anywhere
- 1x USB-A Female Surface Mount Socket [SparkFun](https://www.sparkfun.com/products/9011)
- 1x 5V 1A USB Port Power Supply Anywhere
- 1x USB-A Cable Anywhere
- 1x ESP8266 Wifi Module Anywhere, [SparkFun](https://www.sparkfun.com/products/13678)
- 1x Break-away 0.1" Dual Row Male Header Pin Strip (at least 18 long) Creatron
- 3x Break-away 0.1" Single Row Male Header Pin Strip (at least 10 long) Creatron
- 51 x Molex Part #39000046 (Mini-Fit Female Crimp Terminal 22-28 AWG) [DigiKey](https://www.digikey.ca/product-detail/en/molex/0039000046/WM2503CT-ND/3028710)
- 51 x Molex Part #39000048 (Mini-Fit Male Crimp Terminal 22-28 AWG) [DigiKey](https://www.digikey.ca/product-detail/en/molex/0039000048/WM2502CT-ND/3028711)
- 5 x Micro Servo Creatron
- 5 x 12mm Photoresistor Creatron
- 5 x 10kOhm 1206 SMD Resistors [DigiKey](https://www.digikey.ca/product-detail/en/vishay-dale/CRCW120610K0JNEB/541-CRCW120610K0JNEBCT-ND/11501055)

Servo Connectors:
- 1 x Molex Part #39012160 (Intermediate connector for servo wires (M) 16 wire) [DigiKey](https://www.digikey.ca/products/en?keywords=39012160)
- 1 x Molex Part #39289168 (Board connector for servo wires (F) 16 wire) [DigiKey](https://www.digikey.ca/products/en?keywords=39289168)
- 5 x Molex Part #39014032 (Intermediate connector for servo wires (M) 3 wire) [DigiKey](https://www.digikey.ca/products/en?keywords=39014032)
- 5 x Molex Part #39014030 (Intermediate connector for servo wires (F) 3 wire) [DigiKey](https://www.digikey.ca/products/en?keywords=39014030)

Photoresistor Connectors:
- 1 x Molex Part #39012100 (Intermediate connector for the photo-resistors (M) 10 wire) [DigiKey](https://www.digikey.ca/products/en?keywords=39012100)
- 1 x Molex Part #39289108 (Board connector for the photo-resistors (F) 10 wire) [DigiKey](https://www.digikey.ca/products/en?keywords=39289108)
- 5 x Molex Part #39012020 (Intermediate connector for the photo-resistors (M) 2 wire) [DigiKey](https://www.digikey.ca/products/en?keywords=39012020)
- 5 x Molex Part #39012021 (Intermediate connector for the photo-resistors (F) 2 wire) [DigiKey](https://www.digikey.ca/products/en?keywords=39012021)

MaiHameed, 2020-03-10:
Target Base 3D Print Design
---

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
