OpenLiberty/space-sentry-challenge/(commit log)

2019-05-30 adding current version of hardware firmware
2019-06-04 sample code
2019-06-06 status board
2019-06-07 add button control
2019-06-17 serial comm controlling 2 servos using Processing
2019-06-26 switch between images
2019-07-11 Fixing the admin service and NPE with laser metrics
2019-07-25 stop game button now returns to home page
2019-08-09 disable back button of the browser
2019-08-20 updating arduino firmware code with new mega codes
2019-08-21 Added parts list - Parts list might not be fully complete, need to complete other documentation to see if anything pops up - pcb-shield docs is prepped for completion - still need to add notes and ex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
2019-08-21 Finished v1 of the PCB shield docs
2019-08-21 Cleaned up pcb-shield doc and updated README
2019-08-22 Added pcb-ordering.md instructions
2019-08-22 Added link to PCB ordering video
2019-08-27 Added PCB soldering instructions - adding supporting images to the PCB soldering instructions still pending - made changes to the parts list, forgot to add a few components
2019-08-29 fix the regression where socket is not terminated after visiting admin page
2019-09-04 Added Spaceship circuit schematic
2019-09-05 refactor switch.py
2019-09-07 adding assembly screenshot
2019-09-19 Added spaceship arduino code for build 3
2019-10-15 Added spaceship arduino code for V3
2019-10-18 Updated soldering instructions
2020-02-15 red led -> blue led
